Projet-bras-robot-ESME-2021/Rasp-Hand/README.md

## Rasp-Hand project
The project is a Hand controlled by a Ps4 joystick and a keypad.
The hand is able to move in 3 different axes.
And should be able to pick a non fragile item 

In Code you can find the whole code.
In Automat, how to launch the code at boot of raspberry.
In HandProject, the hole interpreter (environment).
In other, the links and some other unnecessary files.
In 3D, the 3D modelisation of the hand in solidworks.

This project is made by Paul Gautier, Ines Aivazian and Warith Hussain.
It was in charge of Antoine.
