Projet-bras-robot-ESME-2021/Rasp-Hand/Code/README.md

this is the code with every piece of code separated
 - PSJoystick to give a function to the button of the joystick
 - Motorconfig for all the method of controlling a motor
 - TheMain to manage everything
