Projet-bras-robot-ESME-2021/Rasp-Hand/Rapport_groupe14.pdf

ESME Sudria Paris

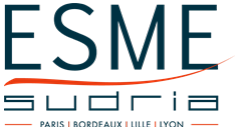
[picture p1: figure]

- 1 -

## REALISATION D’UN BRAS DE ROBOT D’AIDE AUX PERSONNES À MOBILITÉ RÉDUITE

Auteurs : | Encadrants :
AIVAZIAN Inès | FERSZTEROWSKI Antoine
HUSSAIN Warith | CALDAS Alex
GAUTIER Paul

30 mai 2021

- 2 -

# Table des matières

1. Présentation du projet | 5 - 7
1.1 Introduction |
1.2 Liste des exigences |
1.3 Schéma global |
2. Informatique | 8 - 22
2.1 Configuration moteur |
2.2 Mappage de la manette de PS4 |
2.3 Configuration et mappage du keypad |
2.4 Organisation du code main |
2.5 Automatisation |
3. Électronique | 23 - 26
3.1 Composants utilisés |
3.2 Schéma électronique |
4. Mécanique | 27 - 34
4.1 Calculs théoriques |
4.2 Procédé |
4.2.1 Base |
4.2.2 Tronc |
4.2.3 Articulation 1 |
4.2.4 Articulation 2 |
4.2.5 Pince |
5. Management | 35 - 36
5.1 Diagramme de Gantt |
5.2 Difficultés et Résultats |
6. Bilan | 37
6.1 Conclusion |
6.2 Ouverture |

Sources

- 3 -

# Liste des figures

1 Schéma global du projet |
2 Schéma global du projet (partie informatique) |
3 Code configuration moteur (1) |
4 Code configuration moteur (2) |
5 Code mappage de la manette de PS4 (1) |
6 Code mappage de la manette de PS4 (2) |
7 Code mappage de la manette de PS4 (3) |
8 Code mappage de la manette de PS4 (4) |
9 Code mappage de la manette de PS4 (5) |
10 Code mappage de la manette de PS4 (6) |
11 Code configuration et mappage du keypad (1) |
12 Code configuration et mappage du keypad (2) |
13 Code configuration et mappage du keypad (3) |
14 Code configuration et mappage du keypad (4) |
15 Code configuration et mappage du keypad (5) |
16 Code configuration et mappage du keypad (6) |
17 Code configuration et mappage du keypad (7) |
18 Code configuration et mappage du keypad (8) |
19 Code configuration et mappage du keypad (9) |
20 Code configuration et mappage du keypad (10) |
21 Code main |
22 Automatisation (1) |
23 Automatisation (2) |
24 Schéma global du projet (partie électronique) |
25 Raspberry pi 3B+ |
26 Servomoteurs MG996R |
27 Convertisseur DC-DC LM2596 |
28 Clavier 4x4 (keypad) |
29 Manette de PS4 |
30 Schéma électronique |
31 Schéma global du projet (partie mécanique) |
32 La D-H représentation du bras de robot |
33 Modélisation 3D du bras de robot (Solidworks) |
34 Première pièce : la base |
35 Seconde pièce : le tronc (vue du dessous) |
36 Seconde pièce : le tronc (vue du dessus) |
37 Troisième pièce : l’articulation 1 |
38 Quatrième pièce : l’articulation 2 |
39 Cinquième pièce : la pince |
40 Diagramme de Gantt |

- 4 -

# Remerciements

Tout d’abord, il nous semble évident de remercier Monsieur CALDAS et Monsieur FERSZTEROWSKI pour le temps et l’énergie qu’ils ont consacrés à nous encadrer et à nous guider tout au long de ce projet. Nous les remercions également pour avoir mis à notre disposition le matériel de l’école, afin de réaliser au mieux notre projet. Malgré la situation actuelle, Monsieur FERSZTEROWSKI a su se rendre disponible au maximum via teams pour nous aider.

Nous tenons ensuite à remercier Madame THERY et les élèves de la Maker Team de nous avoir donné l’accès au FabLab, notamment pour l’impression 3D de nos pièces.

Nous remercions aussi quelques élèves de l’ESME Sudria qui ont pu nous apporter une aide ponctuelle sur la partie théorique du module mécanique.

Pour finir, nous remercions tous nos professeurs de nous avoir enseigné le savoir essentiel qui nous a permis de mener à bien ce travail.

- 5 -

# 1. Présentation du projet

## 1.1 Introduction

Que ce soit à la suite d’une expérience fortuite ou de longues études sur un sujet, l’Homme essaie toujours d’améliorer sa qualité de vie. En commençant par la maitrise du feu, il est aujourd’hui dans l’ère du numérique. Pour effectuer une tâche plus rapidement ou avec plus de précision par exemple, bon nombre de processus sont automatisés, à l’instar des chaines de production automobiles, grâce à la robotique.

Un robot permet d’effectuer, grâce à un système de commande automatique à base de micro-processeur, une tâche précise pour laquelle il a été conçu dans le domaine industriel, scientifique, militaire ou domestique. Dans le cadre de notre projet, nous souhaitons nous focaliser sur l’aspect médical et essayer de venir en aide aux personnes à mobilité réduites. En effet, en France, plus de 8 millions de personnes déclarent avoir une ou plusieurs déficiences motrices, ce qui représente environ 13% de la population.

Nous avons donc décidé de consacrer notre réflexion à la création d’un bras robotisé pour venir en aide aux personnes qui subissent une motricité difficile, et parfois impossible.

Le premier bras articulé (Unimate) est créé en 1954 par l’américain George Devo dans le but d’être utilisé dans l’industrie nucléaire.
Depuis, les bras robotisés se sont propagés à tous les domaines et permettent de faire de nombreuses tâches : déplacer de lourds objets, aider les chirurgiens lors d’opérations complexes, récupérer des échantillons sur des astéroïdes…

Notre objectif est donc de répondre à la problématique suivante : Comment pourrions-nous aider les personnes à mobilité réduite, grâce à nos connaissances et aux acquis de la technologie ?

Dans ce cahier des charges, nous aborderons plusieurs parties. Dans un premier temps, nous présenterons le projet dans sa globalité. Ensuite, nous expliquerons en détail les trois grands modules qu’il comporte : l’informatique, l’électronique et la mécanique. Pour finir, nous étudierons l’aspect management d’un tel processus.

- 6 -

## 1.2 Liste des exigences

Le but de ce projet est de réaliser un bras robotisé pouvant bouger sur trois axes, muni d’une pince et pouvant attraper des objets du quotidien plus ou moins lourds. Pour ce faire, plusieurs exigences nous ont été données :

Déplacement

- Le système doit avoir 3 degrés de liberté
- Le système doit être contrôlable grâce à une manette
- Le système doit déplacer un objet d’un point A à un point B
- Le système doit effectuer des mouvements avec fluidité

Équipements

- Le système doit être muni d’une pince
- Cette pince doit permettre la saisie d’un objet non fragile

Technique

- L’ensemble des pièces mécaniques seront à imprimer à l’imprimante 3D
- Les pièces seront modélisées sur Solidworks
- Le système sera contrôlé par raspberry

Livrable

- Le code et la documentation seront livrés sous forme de répertoire GitHub
- L’ensemble du livrable permettra à toute personne extérieure au projet de le reproduire

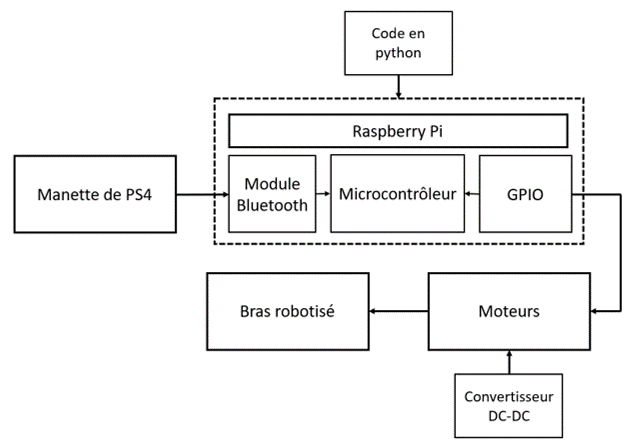
[picture p2: figure]

- 7 -

## 1.3 Schéma global

Figure 1 : Schéma global du projet

Tout d’abord, nous avons utilisé une manette de PS4 qui envoie les données utilisées par Bluetooth à la carte Raspberry Pi. Celle-ci s’occupe de traiter ces données grâce à un code implémenté en python. Ensuite, les moteurs deviennent pilotables en activant les joysticks et bouton de la manette. Enfin, nous avons utilisé un convertisseur DC-DC qui permet d’alimenter les servomoteurs.

Avant de débuter le projet, nous nous sommes préparés à rencontrer des difficultés, que ça soit au niveau du code comme au niveau de la modélisation et de l’impression 3D. Cependant, nos attentes vis-à-vis de ce projet reposent sur des conditions exigées et nous nous sommes efforcés de mener au mieux possible ce travail d’équipe.

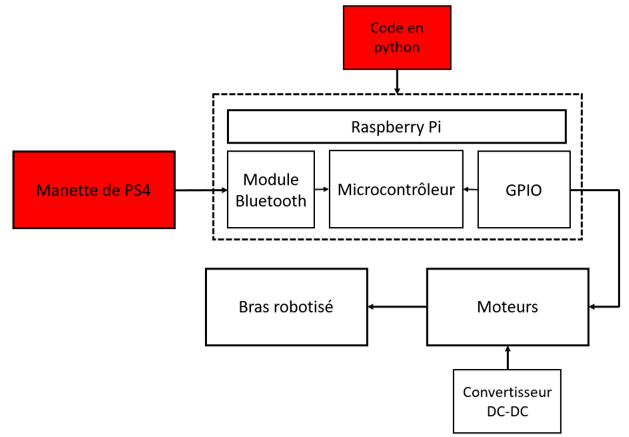
[picture p3: figure]

- 8 -

# 2. Présentation du projet

Figure 2 : Schéma global du projet (partie informatique)

Le code final du projet est séparé en 4 blocs distincts : la configuration du moteur, le mappage de la manette de PS4, la configuration et le mappage du keypad, et enfin le code main faisant appel aux fonction nécessaires.

C’est donc dans cet ordre bien défini que la partie informatique sera détaillée avec des captures d’écran pour chaque sous-partie.

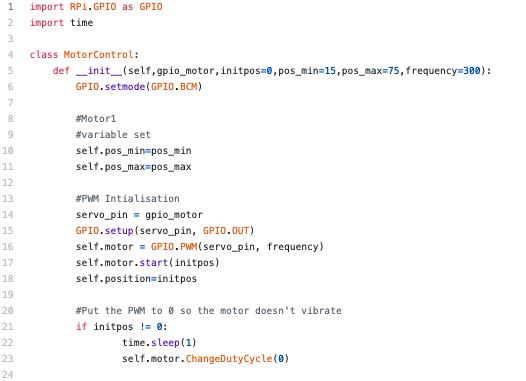
[picture p4: figure]

- 9 -

## 2.1 Configuration moteur

Les servomoteurs sont contrôlés en position à l’aide d’une PWM qui est expliquée plus en détails dans la partie Électronique. La carte Raspberry Pi ayant 2 pins PWM hardware, nous utilisons des GPIOs basiques pour générer une SoftPWM. Nos moteurs sont des servos digitaux et il est donc possible d’augmenter la fréquence afin d’améliorer la précision des positions. Dans ce cas, nous avons utilisé une fréquence de 300 Hz.

Figure 3 : Code configuration moteur (1)

La commande Import RPI.GPIO permet d’importer une librairie qui est nécessaire afin d’utiliser les GPIOs de la Raspberry Pi.
Pour ce projet, nous avons utilisé 4 moteurs avec une configuration presque similaire, et donc coder des classes et des méthodes afin de les configurer et les contrôler. Les objets de chaque moteur seront créés dans le module principal à l’aide des paramètres situés dans le constructeur.
Les moteurs ont chacun un pin assigné (sinon ils vont tourner en même temps), on met donc en paramètre le pin du moteur, ici gpio_motor.

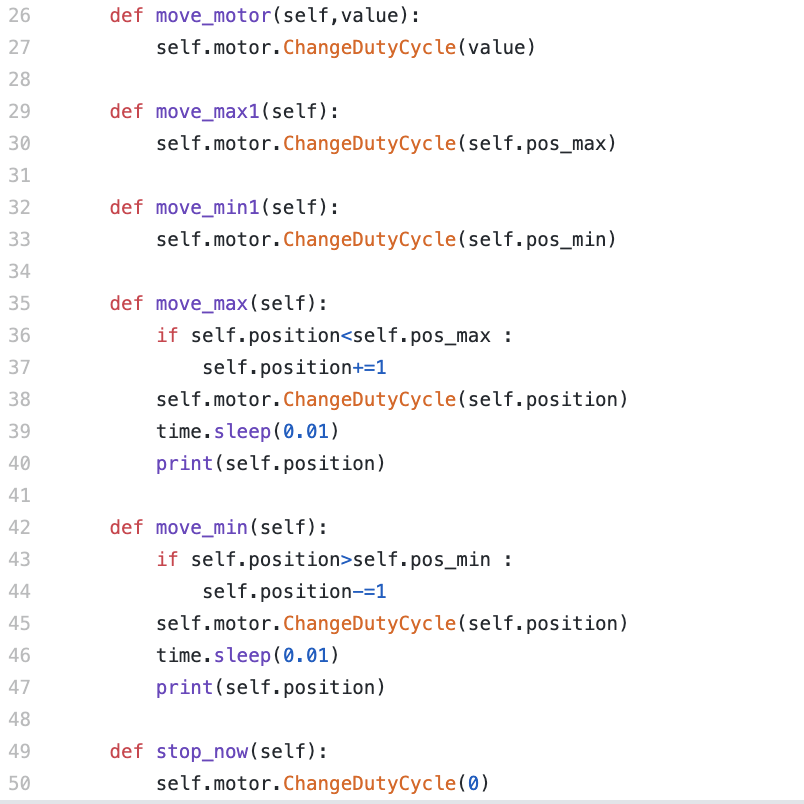
[picture p5: figure]

- 10 -

Puis, nous avons initialisé 3 autres paramètres qui ont une valeur par défaut.
- La position initiale, qui est à 0 par défaut qui signifie que le moteur ne tournera pas et ne prendras pas de position en particulier.
- La position minimale, qui est à 15 par défaut qui correspond à 0°.
- La position maximale, qui est à 75 qui correspond à 180°
Lorsque l’on donne une position initiale au moteur (initpos différent de 0), on laisse le temps au moteur de prendre la position, et on remet la PWM à 0, à l’aide de la fonction ChangeDutyCycle, pour stopper les tremblements du moteur.

Figure 4 : Code configuration moteur (2)

- 11 -

Nous avons créé des méthodes et des classes afin de contrôler le moteur ; pour cela, il y a 3 façons de procéder :
- Move_motor qui prend en paramètre une valeur (entre la position min et la position max) afin d’atteindre une position voulue. Cette méthode est pratique lorsque nous voulons atteindre une position précise.
- Move_min1 et Move_max1 qui permettent d’atteindre la position minimale et la position maximale. Mais associer à la fonction stop_now, qui elle remet la PWM à 0, nous pouvons arrêter le moteur avant qu’elle n’atteigne la position.
Cette méthode fonctionne seulement pour les servos Moteur MG996R en high torque. La raison de se fonctionnement et la différence des moteurs testé sera expliquée dans la partie électronique.
- Move_min et Move_max sont des fonctions qui font incrémenter et décrémenter la variable de position et la renvoie au moteur pour changer la position et la maintenir. Sachant qu’en maintenant une PWM à une valeur particulière le moteur peux avoir des interférences et tremblé. On peut donc mettre la PWM à 0 avec stop_now, pour stopper le moteur.

En stoppant le moteur, le moteur devient hors tension, et perd donc de sa puissance. Avec le poids du bras, le moteur tourne et fais rabaisser les bras. Il ne faut donc pas mettre la PWM à 0 afin de maintenir le bras en position voulu.

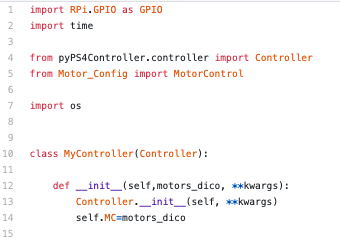
[picture p6: figure]

- 12 -

## 2.2 Mappage de la manette de PS4

La manette de PS4 se connecte à la Raspberry Pi via le module Bluetooth interne à la carte, et nous récupérons les données de la manette grâce à la librairie pyPS4Controller.
Dans la librairie, la class Controller est celle qui initialise la connexion. Quand une manette est connectée, elle à un fichier dans ce chemin ‘/dev/input/js0’ il faut donc appeler la class Controller avec en paramètre « interface = » le chemin. Avec la méthode « listen », on attend que la manette se connecte. Elle vérifie si le fichier existe dans le chemin donné pendant un temps timeout qui vaut 30s par défaut.
Puis on écoute quelle touche est appuyée, qui va faire lancer les méthodes de la Classe Action dépendant des touches appuyées.
Jusque-là nous avons expliqué comment fonctionne la librairie ; dans notre code, on importe la librairie et on surcharge la class Action afin de pouvoir donner de nouvelles actions à nos touches ce qui va nous permettre de contrôler les moteurs.

Figure 5 : Code mappage de la manette de PS4 (1)

Nous importons donc la librairie mais aussi notre class de Configuration Moteur, afin d’utiliser les méthodes pour les contrôler.
Dans notre Module principal qui fait exécuter tout notre programme, nous avons créé un dictionnaire qui va regrouper les 4 moteurs. Nous mettons donc un dictionnaire en paramètre “motors_dico“ et le mettons dans une variable de classe Self.MC.

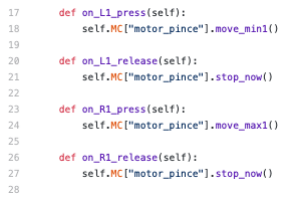
[picture p7: figure]
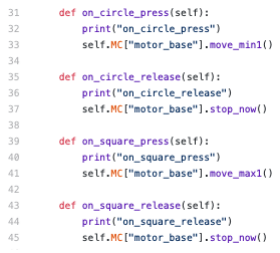
[picture p8: figure]

- 13 -

Figure 6 : Code mappage de la manette de PS4 (2)

Nous utilisons les boutons R1 et L1 de la manette de PS4 pour serrer ou desserrer la pince. Comme vous pouvez le voir, on appelle le dictionnaire stocker dans Self.MC, on annonce lequel des moteurs on souhaite contrôler, dans ce cas “motor_pince“, puis pour la pince. Puisque nous avons mis les servomoteurs en rotation continue, ils sont contrôlables uniquement par le sens et la vitesse. Nous utilisons donc la méthode move_max1 et move_min1 pour choisir le sens de rotation et nous stoppons le moteur lorsque l’on relâche le bouton.

Figure 7 : Code mappage de la manette de PS4 (3)

Vu que nous avons choisi de mettre les moteurs à rotation continue sur la base et la pince, pour le moteur de la base nous utilisons le même principe que pour la pince. Ici, nous avons utilisé les boutons rond et carré pour faire tourner le bras par rapport à la base.

Le code pour les articulations 1 et 2 sont toujours en phase de test.

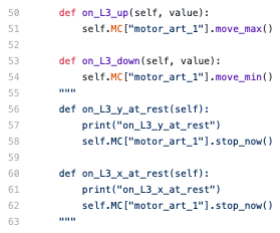
[picture p9: figure]
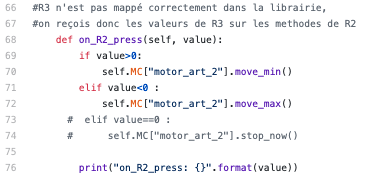
[picture p10: figure]

- 14 -

Le souci est que lorsqu’un moteur n’est plus fourni en PWM (PWM=0) il n’est plus sous tension, or un moteur hors tension ne possède plus ses capacités de couples. Et à ce moment-là, il ne maintient plus le bras dans sa position. C'est pourquoi nous utilisons les méthodes move_max et move_min pour ces moteurs afin de les contrôler en position et de maintenir la position avec la PWM constamment allumée.

Figure 8 : Code mappage de la manette de PS4 (4)

Comme vous pouvez le voir ici, nous avons commenté la partie où nous mettons la PWM à 0 car sinon le bras retombe.
Nous utilisons l’axe Y du joystick gauche de la manette pour contrôler la première articulation. À savoir que les joysticks renvoient des valeurs tant qu’ils changent de position. Les méthodes de déplacement du moteur ne font qu’incrémenter et décrémenter seulement lorsque nous changeons la position. La position étant très précise, tant qu’on ne met pas le joystick tout en haut ou tout en bas, la position ne reste pas stable donc la méthode se relance constamment et fait donc incrémenter et décrémenter en continue tant qu’on ne relâche pas le joystick.

Figure 9 : Code mappage de la manette de PS4 (5)

- 15 -

Les gâchettes R2 et L2 renvoient aussi des valeurs en fonction de la pression sur la touche. Mais le mappage n’ayant pas été bien fait dans la librairie, on_R2_press correspond en fait à R3_up et R3_down. Lorsque l’on baisse le joystick droit la méthode on_R2_press retourne une valeur négative et lorsque l’on monte le joystick, une valeur positive est retournée. Et lorsqu'on relâche le joystick, value vaut 0. On vérifie donc la valeur retournée et on fonction de son signe on incrémente ou décrémente sa position. Et lorsque value vaut 0, on ne fait rien pour maintenir la position donnée.

Figure 10 : Code mappage de la manette de PS4 (6)

Lorsque nous appuyons sur le bouton option, on lance le script disconnect.sh qui fais déconnecter la manette de la Raspberry Pi. Ceci permet de redonner la main au Keypad.

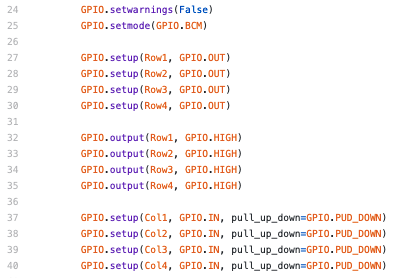
[picture p11: figure]

- 16 -

## 2.3 La configuration et mappage du Keypad

Pour le Keypad, il existe des librairies sur internet mais voulant un parfait contrôle sur ce que l’on fait avec le keypad, et n’ayant pas pu trouver ça sur les librairies existantes, nous avons réutilisé un code que l’un de nous a eu l’occasion de coder lors de son semestre à Lisbonne, mais en langage C. Nous avons donc traduit le code en python mais par manque de temps, nous n'avons pas pu l’optimiser.

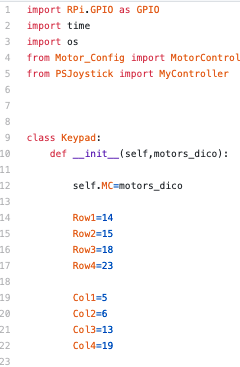
[picture p12: figure]

Figures 11 et 12 : Code configuration et mappage du keypad (1 et 2)

Notre Keypad est notre contrôleur principal, il peut contrôler le moteur mais aussi passer la main à la manette. C'est pourquoi on importe la Class MyController et MotorControl.

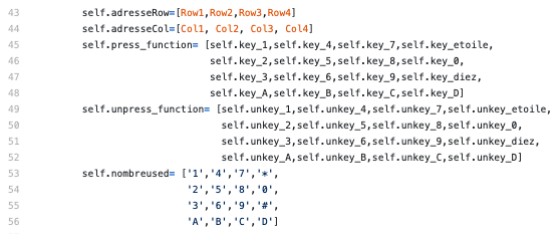
[picture p13: figure]

- 17 -

Comme pour la manette à l’appelle du keypad nous lui rentrons en paramètre le dictionnaire des moteurs pour pouvoir contrôler les moteurs un par un. On le stock donc dans une variable de class self.MC. On associe les pins utilisés sur la Raspberry au variable Row et Col correspondant. Puis on initialise les pins des lignes en pin de sortie et on les met directement en état haut. On initialise ensuite les pins des colonnes en pins d’entrées et on les associe digitalement à des résistance pull-down, la Raspberry nous permet d’utiliser des résistances pull-up et pull-down en software. Les résistances pull-down permettent de maintenir les pins d’entrées en état bas lorsqu’aucune valeur n’est rentrée. Cela évite d’avoir des valeurs flottantes lorsqu’aucune touche n’est appuyée.

Figure 13 : Code configuration et mappage du keypad (3)

Nous créons ici différents tableaux. La première pour regrouper les adresses des lignes et la deuxième pour regrouper les adresses des colonnes.
Puis nous faisons 3 tableaux qui correspondent à nos matrices d’entrée. Les variables à l’intérieur vont être sélectionnées en fonction du bouton appuyé.

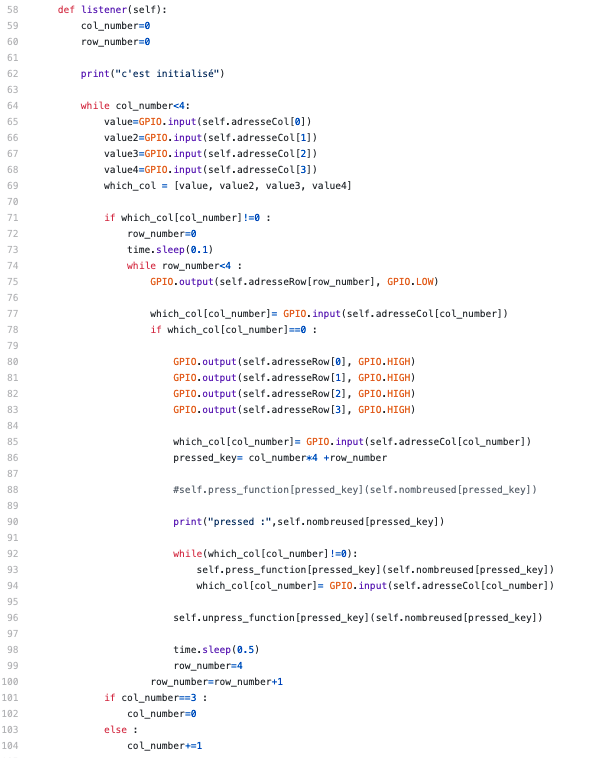
[picture p14: figure]

- 18 -

Figure 14 : Code configuration et mappage du keypad (4)

Le principe du keypad est expliqué dans la partie électronique. On a une variable col_number qui s’incrémente de 0 à 4 et qui tourne en boucle infinie car si cette variable vaut 4 elle est remise à 0. Cela sert à regarder la valeur de chaque colonne et que si une des colonnes (qui lit un état bas par défaut) lit un état haut, on essaye de savoir quelle ligne nous correspond.
On stocke donc la valeur que reçoivent les colonnes dans un tableau (l.80 à l.85), et si l’une des valeurs est différentes de 0, on sait que c’est un bouton de cette colonne qui est appuyé.

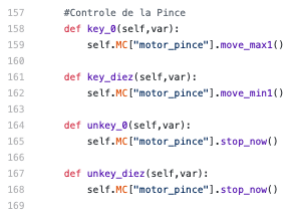
[picture p15: figure]
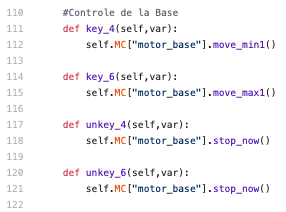
[picture p16: figure]

- 19 -

Maintenant pour vérifier la ligne du bouton appuyé, on fait incrémenter la variable row_number de 0 à 4. Pour chaque valeur de row_number on met à l’état bas la ligne correspondante et on vérifie si la colonne lit un changement d’état. Si la colonne lit un état bas, on a trouvé la colonne et la ligne correspondant au bouton que nous avons appuyé.
Dès que c’est trouver, on remet les pins des lignes en état haut ; à ce moment-là, la colonne lit un état haut et c’est seulement lorsque l’on relâche le bouton que le pin de la colonne lira un état bas (celui de la résistance pull-down).
Grâce à cette méthode nous pouvons lancer des fonctions que nous voulons lancer qu’une seule fois si le bouton est appuyé, relancer des fonctions tant que le bouton est appuyé, et lancer des fonctions lorsque c’est relâché. On peut donc utiliser la méthode d’incrémentation de la position des moteurs qui nécessite d’être appelé tant que le bouton est appuyé, et utiliser la méthode d’arrêt des moteurs lorsque l’on relâche le bouton.
On a un time.sleep d’une demie seconde à chaque appui de bouton pour laisser le temps aux états de se recalibrer.
La variable pressed_key nous fait le calcul pour avoir la position du bouton correspondant à la ligne et la colonne dans les matrices de fonctions.

Figures 15 et 16 : Code configuration et mappage du keypad (5 et 6)

Key_4 est la méthode qui permet de mettre la position du moteur de la base à 0° et key_6 à 180°, en relâchant les boutons, les méthodes unkey_4 et unkey_6 se déclenchent et stoppent le moteur. On utilise donc le même principe pour la pince.
On utilise les boutons 4 et 6 pour faire tourner la base. Et les boutons 0 et # pour contrôler la pince.

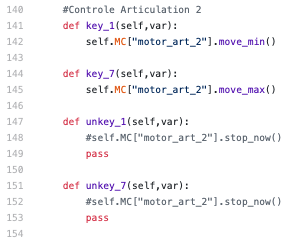
[picture p17: figure]
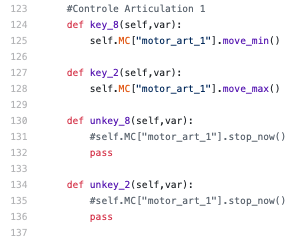
[picture p18: figure]
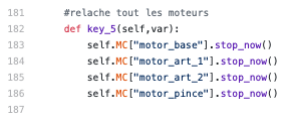
[picture p19: figure]

- 20 -

Figures 17 et 18 : Code configuration et mappage du keypad (7 et 8)

Les moteurs des articulations ont à peu près le même principe que les 2 autres moteurs mais en relâchant les boutons on ne doit juste rien faire, on ne met pas la PWM à 0.
Et ici comme pour la manette de PS4, on utilise les méthodes move_min et move_max pour les moteurs pour modifier les valeurs de position et la maintenir. On utilise ici les touches 2 et 8 pour l’articulation 1 et les touches 1 et 7 pour l’articulation 2.

Figure 19 : Code configuration et mappage du keypad (9)

Vu que le maintien d’une position via la PWM fait trembler les moteurs, en appuyant sur 5 on met toute les PWM à 0 même si cela relâche les moteurs. On a le même principe qu'un bouton de Kill program. Mais nous pouvons reprendre nos mouvements après.

Figure 20 : Code configuration et mappage du keypad (10)

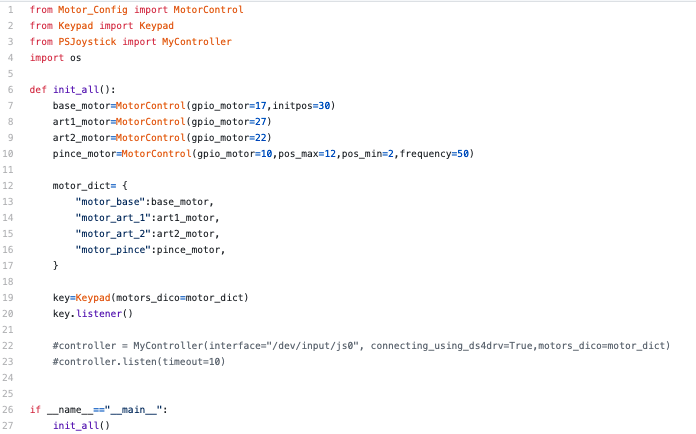
[picture p20: figure]

- 21 -

La touche * nous permet de nous connecter à la manette de PS4, on essaye de lancer le script connect.sh, pour connecter la manette via Bluetooth et on lance la méthode listen de la manette pour l’utiliser, si la connexion ne s’est pas faite au bout de 10s, on repasse sur le keypad.

On ne peut pas utiliser les 2 contrôleurs simultanément (le Keypad et la manette de PS4). Donc quand on se connecte sur la manette de PS4, il faut la déconnecter pour repasser sur le keypad.

## 2.4 Organisation Main

Figure 21 : Code main

Ici on lance tout notre programme. On crée un objet de moteur pour chaque moteur en associant le pin pour chacun, leur position initiale s’ils en ont, la position minimale et maximale et la fréquence si ça doit changer.
On met tous ces objets dans le dictionnaire motor_dict, et on leur donne des noms que l’on réutilise dans nos Class Keypad et Controller (la manette de PS4).
Puis on lance le listener du keypad en mettant en paramètre de la classe le dictionnaire.

- 22 -

## 2.5 Automatisation

On utilise des scripts Bash pour automatiser notre projet, car nous voulons qu’il fonctionne sans utiliser l’interface graphique de la Raspberry Pi.

Figure 22 : Automatisation (1)

Ce script est nommé runarm.sh, il permet d’activer notre environnement puis lancer le fichier Python ProjectMain.py qui est notre Main.
On lance ce script à l’allumage de la Raspberry Pi en rajoutant “sudo bash /home/pi/runarm.sh &” dans le rc.local qui est un script qui se lance quand on allume la Raspberry Pi.

Figure 23 : Automatisation (2)

Voici le script connect.sh qui permet de connecter un appareil en Bluetooth avec une adresse MAC donnée. Ici, celle de la manette de la PS4.

On a le même script pour déconnecter la manette.

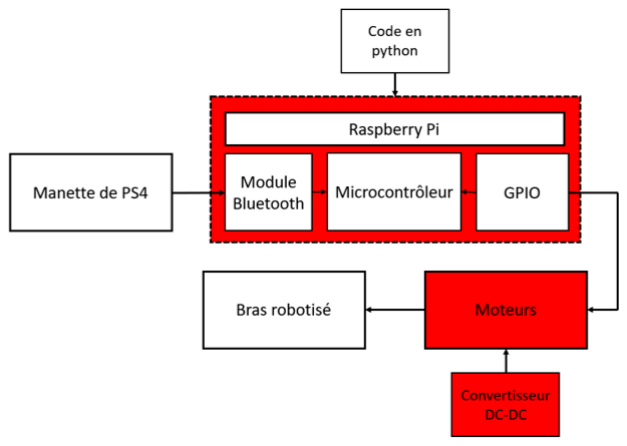
[picture p21: figure]
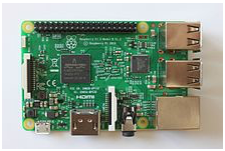
[picture p22: figure]

- 23 -

# 3. Électronique

Figure 24 : Schéma global du projet (partie électronique)

## 3.1 Composants utilisés

- Raspberry Pi 3B +

Figure25 : Raspberry Pi 3B+

Le Raspberry Pi est un nano-ordinateur monocarte à processeur ARM de la taille d'une carte de crédit conçu par des professeurs du département informatique de l'université de Cambridge dans le cadre de la fondation Raspberry Pi3.

Le 14 mars 2018, la fondation Raspberry Pi annonce la mise à jour du Raspberry Pi 3 vers le modèle B+. On y trouve une mise à jour du processeur Broadcom BCM2837B0 64 bit à quatre cœurs ARM Cortex-A53 cadencé à 1,4 GHz au lieu du 1,2 GHz. La puce Cypress CYW43438 est remplacée par une nouvelle puce CYW43455 supportant le WiFi Dual-band 802.11ac et la version 4.2 du Bluetooth. Et d'une prise en charge du Power over Ethernet grâce à un élément supplémentaire.

- 24 -
- Servomoteurs MG996R

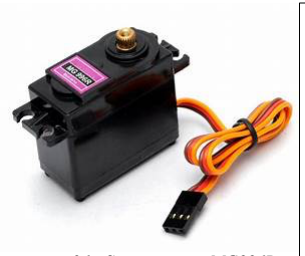
[picture p23: figure]

Figure 26 : Servomoteurs MG996R

- Convertisseur DC-DC LM2596

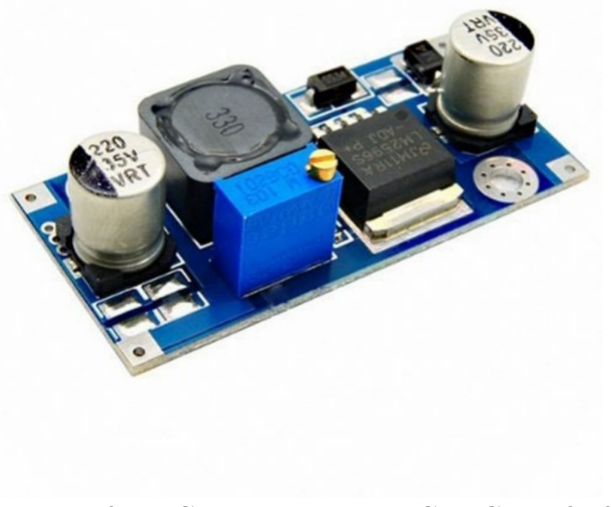
[picture p24: figure]

Figure 27 : Convertisseur DC-DC LM2596

Le MG996R est un servomoteur numérique robuste à engrenages métalliques. Il dispose d’un couple de 11kg/cm et est très utilisé dans les domaines de la robotique, modélisme, domotique et prototypage.
Comme les autres servomoteurs RC, le moteur tourne de 0° à 180° en fonction du cycle d’utilisation de la PWM fournie à sa broche de signal.
Un signal de 0.5ms correspond à 0° et un signal de 2.5ms à 180°. Le temps correspondant à une fréquence de 50Hz est 20 ms. On divise donc 0.5 par 20 pour avoir le dutyCycle correspondant
(notre pos_min et pos_max de l’initialisation du moteur).

Câble rouge : + 5V
Câble orange : PWM
Câble marron : GND

Un convertisseur DC-DC permet de délivrer une tension différente de celle qu’il reçoit.
Pour notre projet, nous utilisons un convertisseur DC-DC LM2596 pouvant recevoir entre 3,2V et 40V et transmettre en sortie de 1,25V à 35V.
Celui-ci est essentiellement composé de deux condensateurs (un en entrée et l’autre en sortie), un transistor, des diodes, une bobine et un potentiomètre. On peut observer la tension de sortie grâce à un voltmètre et ainsi régler la tension souhaitée. Pour modifier cette tension, il suffit de tourner la vis sur le potentiomètre.
Ici, nous désirons une tension de 5V pour alimenter nos moteurs.

- 25 -
- Clavier 4x4 (keypad)

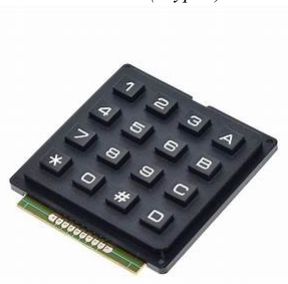
[picture p25: figure]

Figure 28 : Clavier 4x4 (keypad)

- Manette de PS4

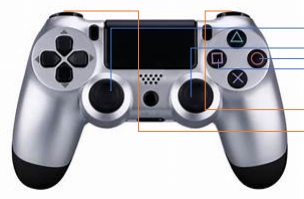
[picture p26: figure]

Figure 29 : Manette de PS4

Le clavier possède 4 broches pour les colonnes et 4 broches pour les lignes qui se relient au moment où l’on appuie sur un bouton. On met donc les colonnes en entrées avec une résistance pull down qui permet de lire un état bas quand rien d’autre n’est entré cela évite de recevoir une valeur flottante et ainsi fausser nos résultats et les lignes en sorties.
Les lignes envoient une valeur différente de 1 (l’état haut) et au moment où l’on appuie sur une touche, la colonne correspondante lit une valeur et après il faut donc déterminer la lignes du bouton appuyé. Pour cela, sachant que la colonne lit un état haut car un bouton est appuyé, on va mettre à l’état bas une par une les lignes afin que la colonne lise un état bas de nouveau. Dès qu’on connait la ligne et la colonne correspondant à la touche appuyée, on sait quelle touche est appuyé.

Instructions pour les servomoteurs

Analogue gauche : Avancer l’articulation 1 Analogue droit : Reculer l’articulation 1 Carrée : Tourner à gauche la base
Rond : Tourner à droite la base
R1 : Serrer la pince
L1 : Desserrer la pince
Option : Passer de la manette au keypad

## 3.2 Schéma électronique

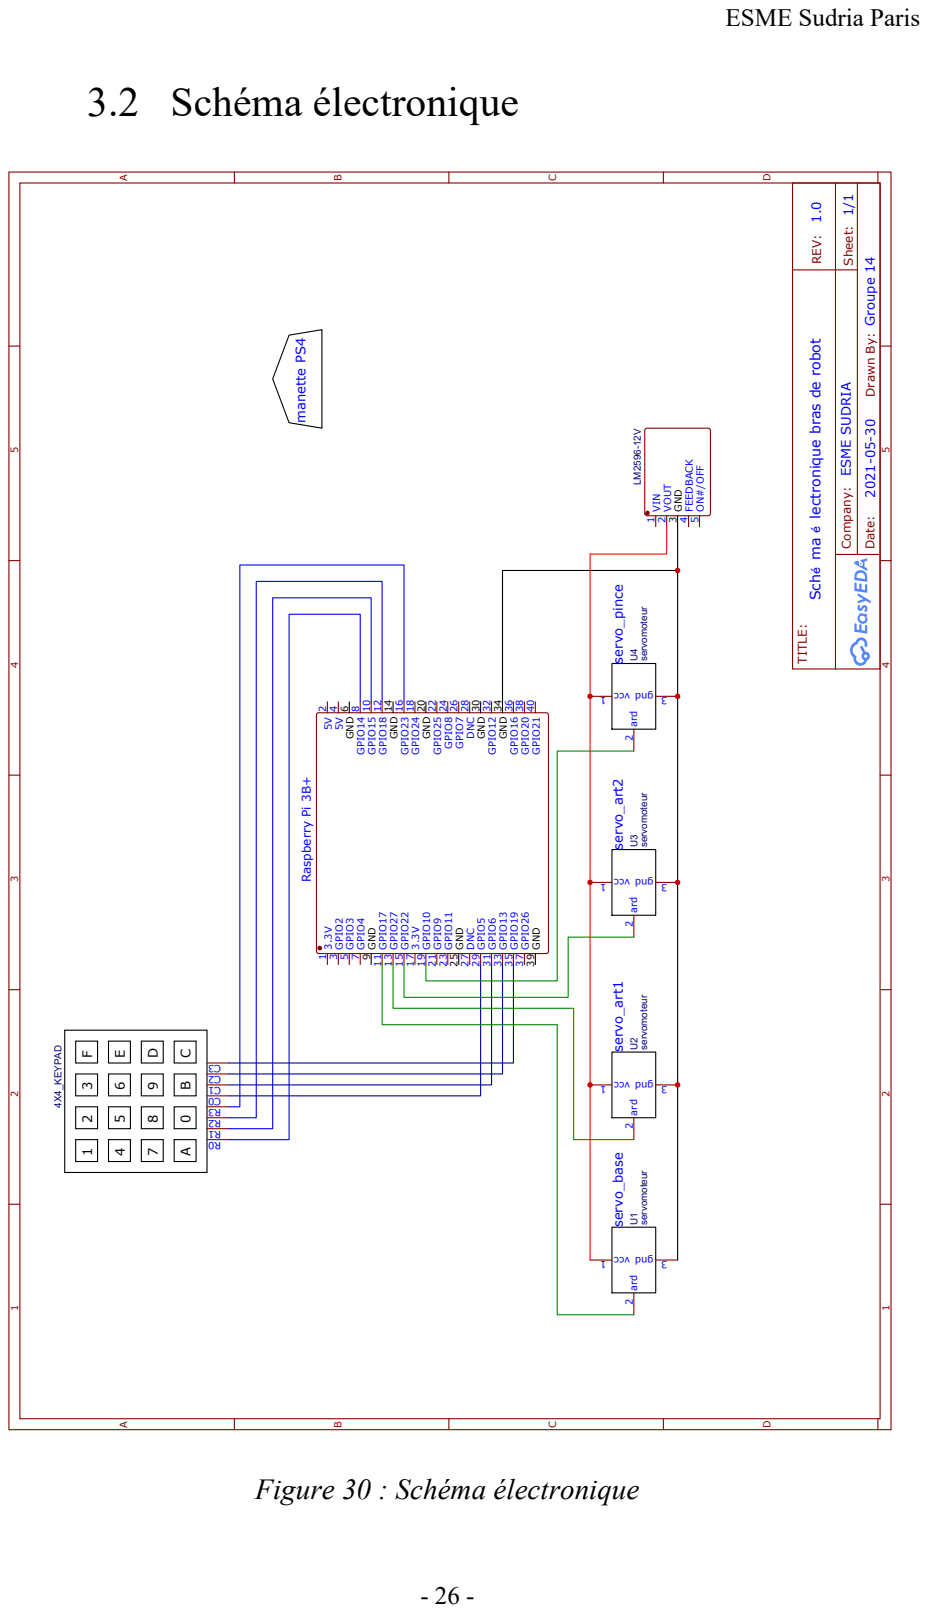
[picture p27: page 26]
TITLE:; Date: 2021-05-30; Sheet: 1/1; servomoteur; servo_base; servo_art1; servo_art2; servo_pince; VIN 1; VOUT 2 GND 3; FEEDBACK 4 ON#/OFF 5; 4X4_KEYPAD; manette PS4; GPIO2 3; GPIO3 5; GPIO4 7 GND 9; GPIO17 11; GPIO27 13; GPIO22 15 3.3V 17; GPIO10 19 GPIO9 21; GPIO11 23 GND 25 DNC 27; GPIO5 29; GPIO6 31; GPIO13 33; GPIO19 35; GPIO26 37; Raspberry Pi 3B+

Sché ma é lectronique bras de robot REV: 1.0

Drawn By: Groupe 14

Company: ESME SUDRIA

GND 39 GPIO21 40 GPIO20 38 GPIO16 36 GND 34 GPIO12 32 GND 30 DNC 28 GPIO7 26 GPIO8 24 GPIO25 22 GND 20 GPIO24 18 GPIO23 16 GND 14 GPIO18 12 GPIO15 10 GPIO14 8 GND 6 5V 4 5V 2

Figure 30 : Schéma électronique

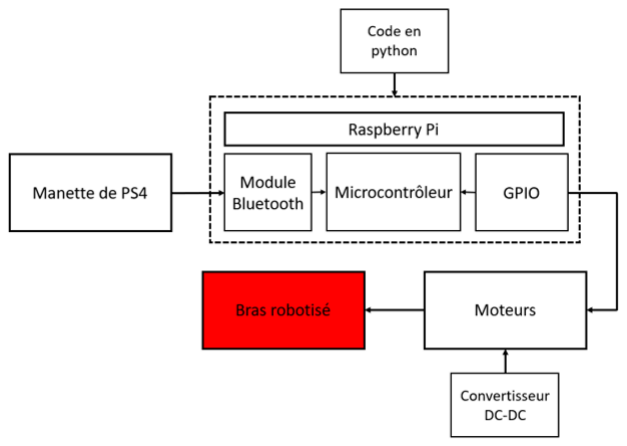
[picture p28: figure]

- 27 -

# 4. Mécanique

Figure 31 : Schéma global du projet (partie mécanique)

## 4.1 Calculs théoriques

Dans ce rapport, nous avons souhaité effectuer les calculs vus en cours de Systèmes Articulés. Il nous semblait important de faire cette partie théorique, afin de mieux intégrer la pratique.

Représentation du bras robotisé
Notre bras robotisé évolue dans l’espace selon trois axes, comme annoncé plus haut : x, y et z. Nos articulations sont toutes rotoïdes, pivotant selon les axes z0, z1 et z2, avec des angles respectifs theta1, theta2 et theta3.
Nous avons également associé d1 à la hauteur du tronc, a2 à la longueur du bras 1, et a3 à la longueur du bras 2 plus celle de la pince.

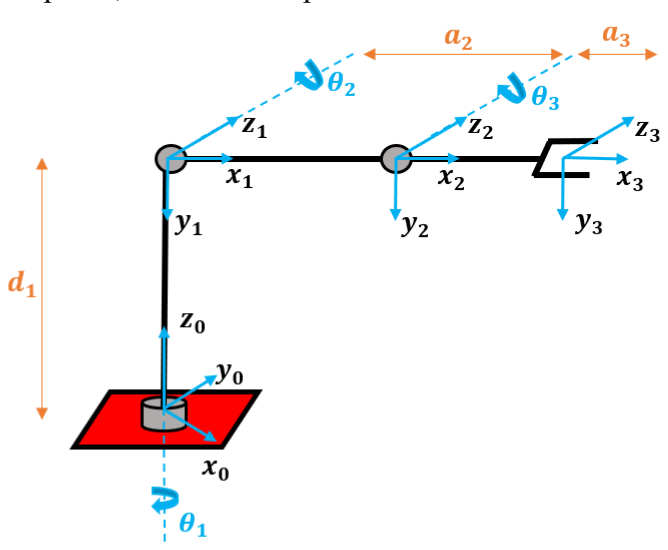
[picture p29: figure]

- 28 -

Pour cette première partie, nous avons représenté notre robot R-R-R suivant :

Figure 32 : La D-H représentation du bras de robot

Paramètres de Denavit-Hartenberg
Nous remplissons le tableau ci-dessous pour chaque paramètre, ce qui va nous aider pour la suite des calculs.
Axe | θ | d | a | α
1 | θ1 | d1 | 0 | -π/2
2 | θ2 | 0 | a2 | 0
3 | θ3 | 0 | a3 | 0

- 29 -

Modèle géométrique direct
Le modèle géométrique direct permet de calculer les coordonnées opérationnelles du robot avec sa position et ses coordonnées articulaires.
Ensuite, nous calculons le modèle géométrique direct. Pour cela, nous devons trouver :

T "#$%

&'()* = T +
, = T +

-. T -

.. T .

,

T +

, = %

C- | 0 −S- | 0
S- | 0 | C- | 0
0 −1 | 0 | d-
0 | 0 | 0 | 1

,.%

C. | −S. | 0 a.C.
S. | C. | 0 a.S.
0 | 0 | 1 | 0
0 | 0 | 0 | 1

, . %

C, | −S, | 0 a,C,
S, | C, | 0 a,S,
0 | 0 | 1 | 0
0 | 0 | 0 | 1

,

⟹ T "#$%

&'()* = T +

, = %

C-C., | −C-S., | S- | C-(a,C., + a.C.)
S-C., | −S-S., | C- | S-(a,C., + a.C.)
−S./, | −C./, | 0 −a,S., − a.S. + d-
0 | 0 | 0 | 1

,

Modèle géométrique inverse
Le modèle géométrique inverse permet de déterminer la configuration des liaisons, en fonction de la position et de l’orientation de l'effecteur du robot. Nous souhaitons ensuite trouver le modèle géométrique inverse. Nous devons trouver w(q) :

w(q) =

⎣

⎢

⎢

⎢

⎢

⎢

⎢

⎡ C-(a,C., + a.C.)
S-(a,C., + a.C.)
−a,S., − a.S. + d-S-exp :

q,
π <

C-exp :

q,
π <
0 | ⎦

⎥

⎥

⎥

⎥

⎥

⎥

⎤

On cherche ensuite à exprimer q!, q", q#.
Pour cela nous utilisons plusieurs formules avec lesquelles on trouve q! et q# assez facilement :
q- = atan2(w. , w,)
q, = π. lnGw0
. , w1

- 30 -

Pour trouver q" , on isole C" et S" afin de l’exprimer en fonction de w! , w" et w# :

C. = w- − C-a, − C.,
C-a.
S. = w, + a,S., − d-a.
q. = atan2(

w, + a,S., − d-a.

,

w- − C-a, − C.,
C-a.

)

Matrice Jacobienne de l’outil
Cette matrice sert à exprimer la vitesse de l’outil en fonction des vitesses articulaires. Elle est utile lorsqu’on souhaite commander un robot pour qu’il suive la trajectoire au préalable calculée.
Pour déterminer v(q), on dérive w(q) par apport à q!, q" et q#. On obtient :

v(q) =

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
−S-(a,C., + a.C.) −C-(a,S., + a.S.) −a,C-S., C-(a,C., + a.C.) −S-(a,S., + a.S.) −a,S-S.,
0 | −a,C., − a.C. | −a,C.,
C-ex p :

q,
π < | 0 | 0

−S-ex p :

q,
π < | 0 | 0
0 | 0 | 0 | ⎦

⎥

⎥

⎥

⎥

⎥

⎥

⎤

Matrice Jacobienne du manipulateur

J(q) =

⎣

⎢

⎢

⎢

⎢

⎡

−S-(a,C., + a.C.) −C-(a,S., + a.S.) −a,C-S., C-(a,C., + a.C.) −S-(a,S., + a.S.) −a,S-S.,
0 | −a,C., − a.C. | −a,C.,
0 | −S- | S-
0 | C- | C-
1 | 0 | 0 | ⎦

⎥

⎥

⎥

⎥

⎤

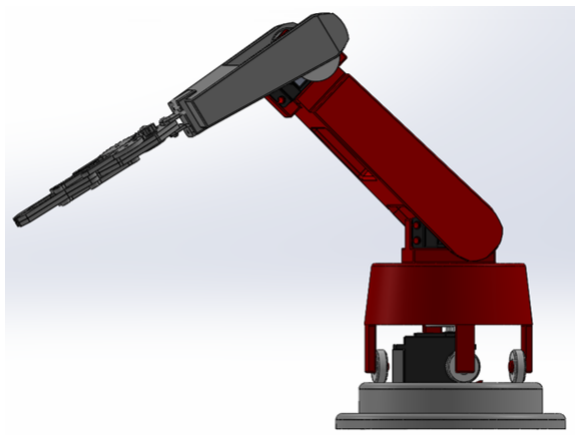
[picture p30: figure]

- 31 -

## 4.2 Procédé

En ce qui concerne la partie mécanique de notre projet, nous avons longuement hésité sur la manière de procéder.

Notre première idée était de construire l’entièreté du robot avec des pièces de mécano dans le but d’obtenir un bras de robot le plus solide possible. Finalement, nous nous sommes rendu compte que cela nous compliquerait la tâche, surtout pour assembler les servomoteurs aux différentes parties du robot. Et puis, nous ne trouvions pas exactement ce que nous avions en tête sur le marché.
Nous avons donc décidé de partir sur une création totale des pièces sur le logiciel de modélisation 3D SolidWorks. Avant de commencer, nous avons établis un schéma sur papier avec les mesures que nous voulions donner à notre robot, sa forme globale et les liaisons que nous allions mettre en place entre chaque partie. Il se compose d’une base, d’un tronc surélevé permettant de faire pivoter le robot, de deux bras, et d’une pince. Afin de ne pas mettre tout le poids du robot sur les moteurs, nous avons pensé à utiliser des roulements à billes. Pour pouvoir avoir une vue d’ensemble pour l’assemblage sur SolidWorks et que cela soit plus simple pour les mesures, nous avons trouvé une modélisation 3D des moteurs MG996R que nous allions utiliser, et nous avons modélisé leurs hélices ainsi que les roulements à billes.

Finalement, nous avons décidé de fixer notre robot sur une planche en bois pour qu’il puisse gagner en stabilité, et si besoin, d’utiliser les pièces de mécano pour le renforcer.

Figure 15 : Modélisation 3D du bras de robot (Solidworks)

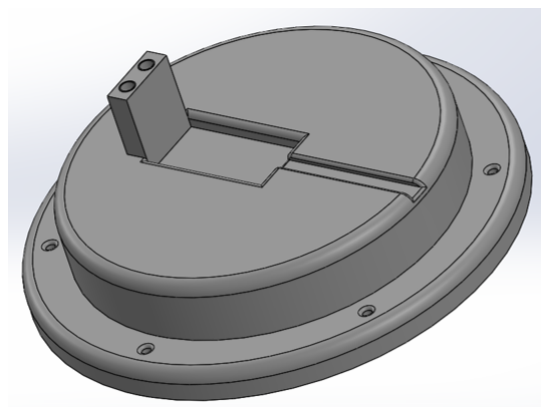
[picture p31: figure]
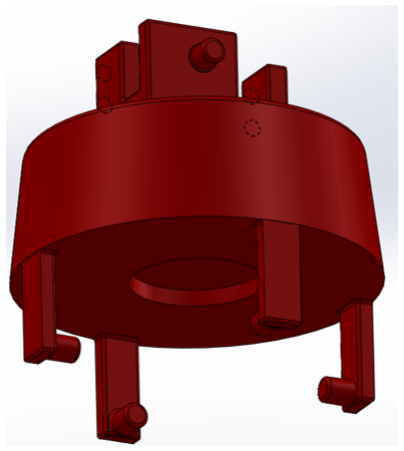
[picture p32: figure]

- 32 -

## 4.2.1 Base

Pour la première pièce qui est la base, nous avons simplement créé un socle de 15cm de diamètre, pouvant contenir un premier moteur dans un creux. Ce premier moteur permet au bras robotisé de pivoter sur lui-même. Nous avons également fait des trous pour pouvoir fixer le moteur à la base et fixer celle-ci sur une planche en bois, ainsi que des rails pouvant accueillir les câbles.

Figure 16 : Première pièce : la base

## 4.2.2 Tronc

La deuxième pièce est ce que nous avons appelé le “tronc”. Il s’agit d’une pièce cylindrique de 12cm, venant se fixer au moteur à l’aide d’un trou creusé sur le dessous, et venant se poser sur la base avec quatre roulements à billes.

Figure 17 : Seconde pièce : le tronc (vue du dessous)

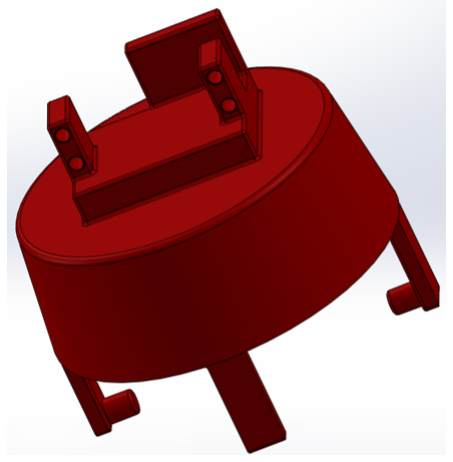
[picture p33: figure]
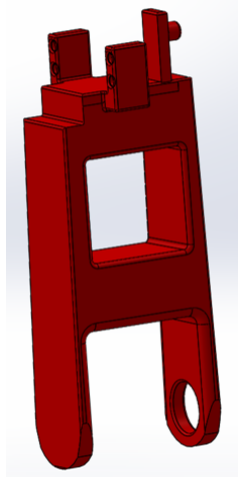
[picture p34: figure]

- 33 -

Sur le dessus de la pièce, nous avons construit un espace qui accueillera le deuxième moteur. Celui-ci va permettre au bras de bouger en hauteur. Nous avons également fait un axe permettant de fixer le premier bras à l’aide d’un roulement à billes.

Figure 18 : Seconde pièce : le tronc (vue du dessus)

## 4.2.3 Articulation 1

La troisième pièce est le premier bras de notre robot. Il mesure 20cm de hauteur et 7cm de largeur. Le troisième moteur sera positionné en haut du bras et il permettra au deuxième bras de bouger en hauteur et d’apporter également la longueur au bras robotisé. Nous avons créé un espace sur une des pattes du bras afin d’y glisser un roulement à billes. Celui-ci fera la liaison avec le tronc.

Figure 19 : Troisième pièce : l’articulation 1

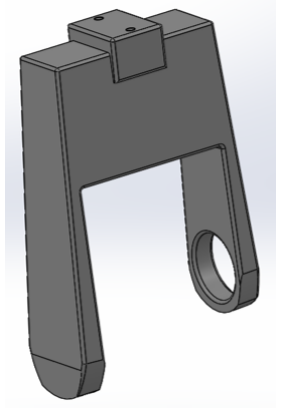
[picture p35: figure]
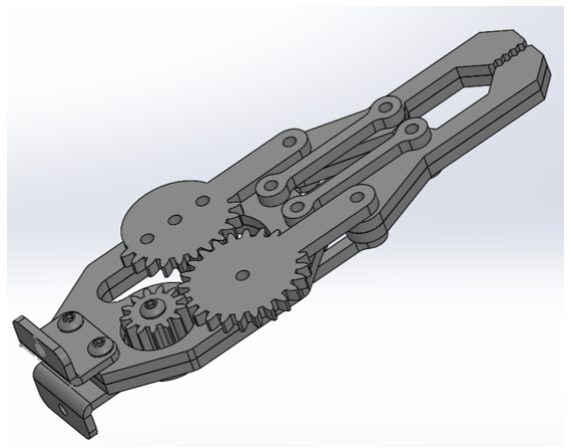
[picture p36: figure]

- 34 -

## 4.2.4 Articulation 2

Ensuite, il y a le deuxième bras qui mesure 11,70 cm. Nous mettrons également un roulement à billes pour pouvoir fixer cette pièce au premier bras.

Figure 20 : Quatrième pièce : l’articulation 2

## 4.2.5 Pince

La cinquième pièce est la pince, pièce finale du robot, qui mesure 13cm de long. Le quatrième moteur va être fixé en dessous de la pince à l’aide d’une vis, et entraîner un engrenage central qui entraînera les deux engrenages secondaires qui, eux-mêmes, feront bouger les bras de la pince. Afin que la pince attrape mieux les objets, nous avons fixé des bouts de caoutchouc sur ses extrémités.

Figure 21 : Cinquième pièce : la pince

- 35 -

# 5. Management

## 5.1 Diagramme de Gantt

Le diagramme de Gantt, couramment utilisé en gestion de projet, est l'un des outils les plus efficaces pour représenter visuellement l'état d'avancement des différentes activités (tâches) qui constituent un projet.

Il permet de répertorier toutes les tâches à accomplir pour mener le projet à bien, et indique la date à laquelle ces tâches doivent être effectuées (le planning).

Le diagramme de Gantt étant trop grand, nous l’avons coupé en deux pour qu’il puisse être plus lisible.

Diagramme de Gantt | 01-mars | 02-mars | 03-mars | 04-mars | 05-mars | 08-mars | 09-mars | 10-mars | 11-mars | 12-mars | 15-mars | 16-mars | 17-mars | 18-mars | 19-mars | 22-mars | 23-mars | 24-mars | 25-mars | 26-mars | 29-mars | 30-mars | 31-mars | 01-avr | 02-avr | 05-avr | 06-avr | 07-avr | 08-avr | 09-avr | 12-avr | 13-avr | 14-avr | 15-avr | 16-avr | 19-avr | 20-avr
Bras de robot | M | T | W | T | F | M | T | W | T | F | M | T | W | T | F | M | T | W | T | F | M | T | W | T | F | M | T | W | T | F | M | T | W | T | F | M | T
Réunions | Réunion 18h

Réunion
18h

Réunion
18h

Activité 1 : Analyse

Analyse des besoins

Rédaction du cahier des
charges

Schéma synoptique

Spécifications des composants

Commande de matériel

Spécifications du code

Activité 2 : Développment

Phase de code

Modélisation 3D

Phase de Test

Activité 3 : Finalisation

Rédaction du rapport

Assemblage

Cahier des charges

Schéma synoptique

Spécifications du code

Recherche des composants

Analyse des besoins

21-avr | 22-avr | 23-avr | 26-avr | 27-avr | 28-avr | 29-avr | 30-avr | 03-mai | 04-mai | 05-mai | 06-mai | 07-mai | 10-mai | 11-mai | 12-mai | 13-mai | 14-mai | 17-mai | 18-mai | 19-mai | 20-mai | 21-mai | 24-mai | 25-mai | 26-mai | 27-mai | 28-mai | 30-mai | 31-mai | 01-juin | 02-juin | 03-juin | 04-juin
W | T | F | M | T | W | T | F | M | T | W | T | F | M | T | W | T | F | M | T | W | T | F | M | T | W | T | F | S | M | T | W | T | F

Réunion
18h

Réunion
18h

Remise du
rapport 18h

Soutenance de
Projet

Assemblage

Acitivté 3 : Finalisation

Rédaction du rapport

Commande de matériel

Activité 1 : Analyse

Modélisation 3D

Phase de code

Activité 2 : Développement

- 36 -

## 5.2 Difficultés et Résultats

Au cours de la réalisation de nos travaux, nous avons rencontré diverses difficultés dans différents domaines.

Modélisation/Impression 3D

- Manque de précision au niveau de la modélisation du bras n°1 et 2, notamment lors de l’emboîtement de ces deux pièces. Il a donc fallu réimprimer ces deux pièces en modifiant certaines mesures sur Solidworks.
- Lors de la mise en place de supports (utiles lors de l’impression), certains d’entre eux étaient inutiles et difficiles à retirer de la pièce.

Composants

- Nous avons eu 4 types de servomoteurs à tester ; l’un d’entre eux étaient défectueux, et les deux autres ne correspondaient pas au cahier des charges qui nous a été donné.

Assemblage des pièces

- Par le manque de temps au niveau des impressions 3D, nous avons dû creuser approximativement le “tronc“ pour y fixer le servomoteur qui le relie à la base.

Mise à part ces quelques difficultés, ce projet a été une réussite.
Tout d’abord, il a été accompli dans la limite du temps imparti et nous a permis d’acquérir de nouvelles compétences notamment au niveau de la modélisation 3D et du code.
De plus, la communication entre les membres de ce groupe et l’encadrant de notre projet était excellente même si cela s’est fait à distance via teams.
Nous sommes heureux de pouvoir présenter un projet fonctionnel qui peut venir en aide aux personnes à mobilité réduite.
Nous partageons l’entièreté du code ainsi que la documentation sur Github afin de permettre à n’importe qui de comprendre et même de réaliser ce projet.

- 37 -

# 6. Bilan

## 6.1 Conclusion

Ce travail nous a permis de concevoir un projet de A à Z : un bras robotisé bougeant sur trois axes et permettant d’attraper un objet pas fragile ni trop lourd, contrôlé par une manette de PS4. Nous sommes parvenus à le réaliser en utilisant nos connaissances en termes d’informatique, d’électronique et de mécanique. Nous en avons aussi beaucoup appris sur ces trois modules, et ce travail nous a permis de gagner en autonomie.

Nous avons également dû nous organiser en groupe : nous nous sommes réunis régulièrement à l’école ou via teams pour se répartir au mieux les tâches et avancer sur le projet petit à petit. Nous avons eu quelques soucis qui ont retardé le planning que nous nous étions imposés, mais nous avons réussi à trouver des solutions, et surtout à ne pas perdre espoir.

## 6.2 Ouverture

A l’avenir, nous pourrions envisager de créer un bras robotisé plus complexe que celui-ci : jouer sur les articulations comme rajouter un bras ou alors donner une fonction de rotation à la pince, créer une interface via laquelle on pourrait directement contrôler le robot, ajouter une caméra, mais également rendre plus « propre » le bras en créant une boîte pour cacher les composants électroniques et améliorer la modélisation 3D de nos pièces…

Il y a beaucoup de choses que l’on pourrait ajouter/améliorer, et cela permettrait une aide encore plus précieuse aux personnes à mobilité réduite qui souhaiteraient bénéficier d’un tel robot !

- 38 -

# Sources

https://www.accessiblepourmoi.com/ce-que-dit-la-loi/les-chiffres-du-handicap/

https://www.monde-proprete.com/sites/default/files/familles_de_deficiences.pdf

https://objectifadvf.wordpress.com/2016/09/02/hemiplegie-paraplegie-tetraplegie/

https://poujouly.net/2012/05/22/convertisseur-dcdc/

https://www.solaris-store.com/content/48-principe-de-fonctionnement-d-un-convertisseur-dc-dc

https://fr.wikipedia.org/wiki/Raspberry_Pi#Modèle_3_B+_(Raspberry_Pi_3+)

https://components101.com/motors/mg996r-servo-motor-datasheet

https://raspberry-pi.fr/servomoteur-raspberry-pi/

Image Raspberry Pi 3B+
https://upload.wikimedia.org/wikipedia/commons/thumb/d/d2/Raspberry_Pi_3_Model_B.JPG/220px-Raspberry_Pi_3_Model_B.JPG

Image Convertisseur DC-DC LM2596 https://tse4.mm.bing.net/th?id=OIP.5nQd_U2SgdZRXKjP8jbKDAHaHa&pid=Api&P=0&w=300&h=300

Image Clavier 4x4 (keypad) https://tse2.mm.bing.net/th?id=OIP.WIb3wZBgXtMjG8csV2ykeAAAAA&pid=Api&P=0&w=300&h=300

Image manette de PS4
https://tse4.mm.bing.net/th?id=OIP.EGTTn8Wsas8JAv8ocU4dvwAAAA&pid=Api&P=0&w=225&h=151
