Projet-bras-robot-ESME-2021/Rasp-Hand/3D/Assemblage_pince_moteur.SLDASM

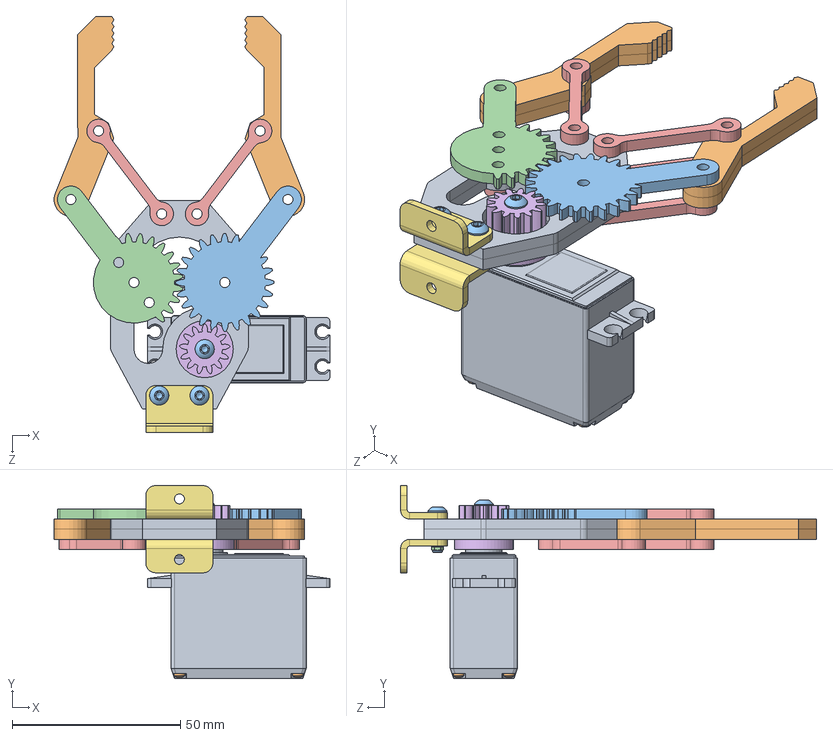
[picture p37: CAD file, 2021-10-26]
3D/Assemblage_pince_moteur.SLDASM
82.0 x 57.4 x 123.7 mm
Arm 03 x 2
Arm 07 x 4
Arm 04
Arm 05
Arm 06 x 6
shaft+engrenage
Arm 02 x 2
Servo Output Shaft
Standard Servo (1501MG)
pan head cross recess screw_iso x 4
socket button head screw_iso x 3
hex thin nut chamfered gradeab_iso x 2
