Projet-bras-robot-ESME-2021/Rasp-Hand/3D/tronc.SLDPRT

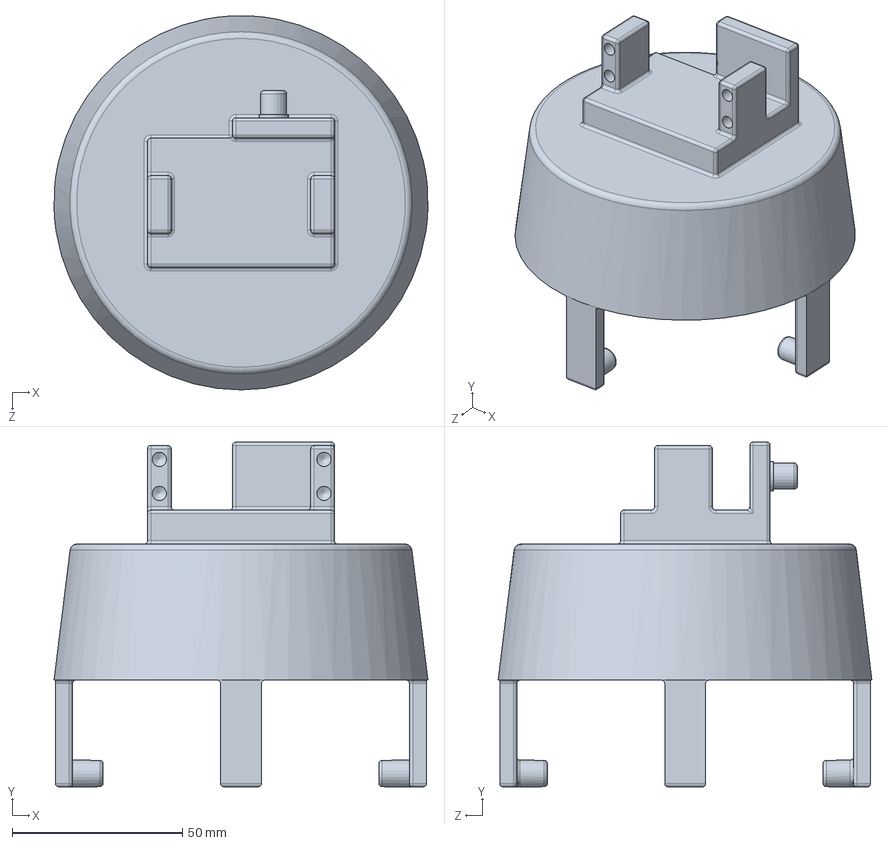
[picture p38: CAD file, 2021-10-26]
3D/tronc.SLDPRT
109.9 x 101.4 x 109.9 mm
