Projet-bras-robot-ESME-2021/Rasp-Hand/3D/Arm 07.SLDPRT

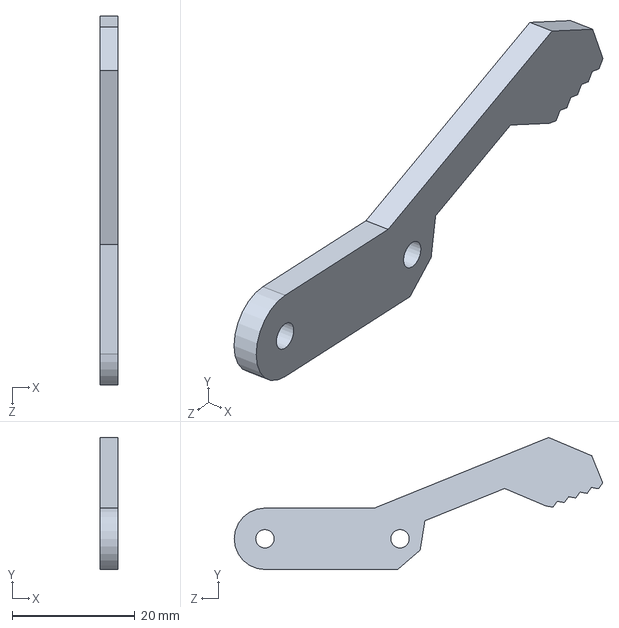
[picture p39: CAD file, 2021-10-26]
3D/Arm 07.SLDPRT
3.00 x 21.5 x 60.0 mm
