Projet-bras-robot-ESME-2021/Rasp-Hand/3D/Arm 04.SLDPRT

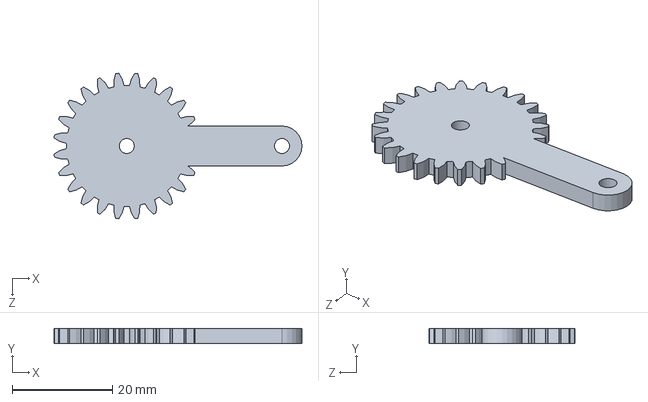
[picture p40: CAD file, 2021-10-26]
3D/Arm 04.SLDPRT
49.5 x 3.00 x 29.1 mm
