Projet-bras-robot-ESME-2021/Rasp-Hand/3D/base - Copie.SLDPRT

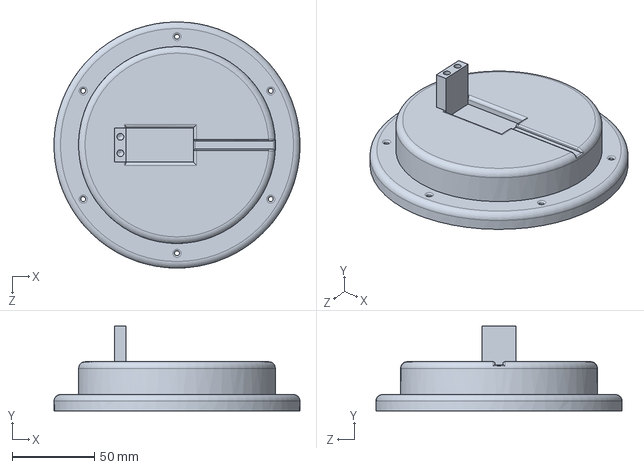
[picture p41: CAD file, 2021-10-26]
3D/base - Copie.SLDPRT
149.9 x 51.7 x 150.0 mm
