Projet-bras-robot-ESME-2021/Rasp-Hand/3D/Arm 02.SLDPRT

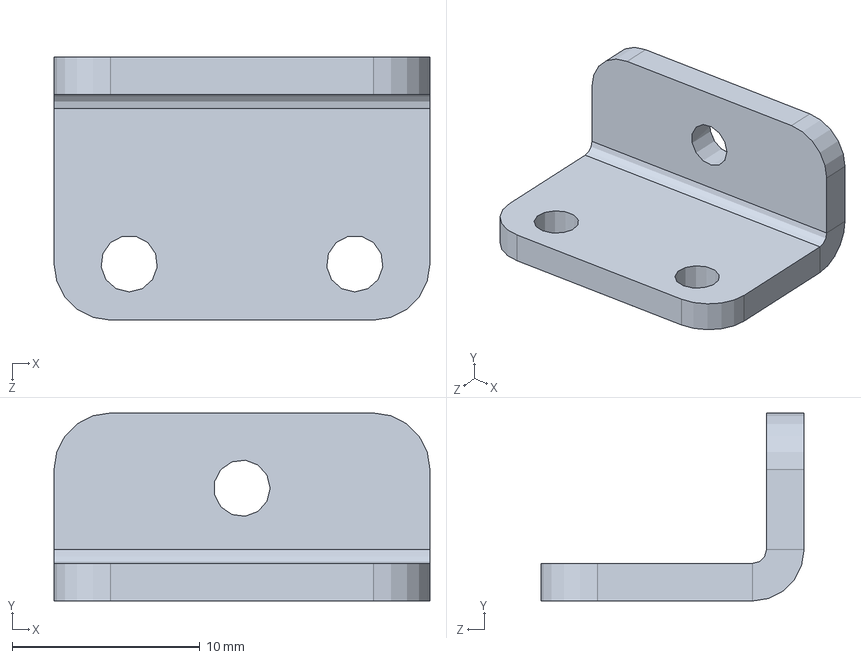
[picture p42: CAD file, 2021-10-26]
3D/Arm 02.SLDPRT
20.0 x 10.0 x 14.0 mm
