Projet-bras-robot-ESME-2021/Rasp-Hand/3D/bras 2 vf - Copie.SLDPRT

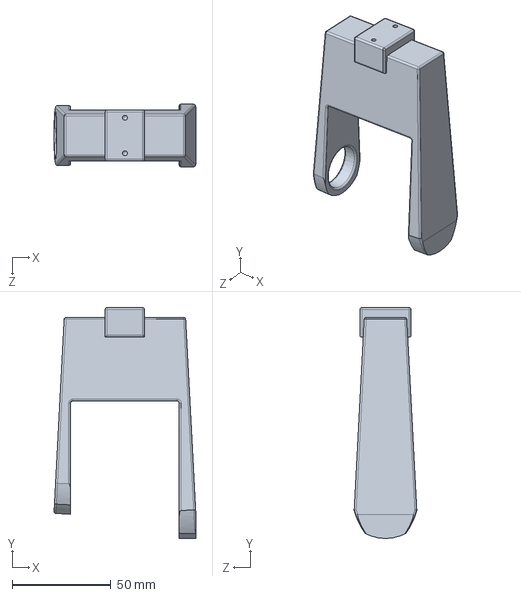
[picture p43: CAD file, 2021-10-26]
3D/bras 2 vf - Copie.SLDPRT
71.9 x 117.1 x 31.8 mm
