Projet-bras-robot-ESME-2021/Rasp-Hand/3D/shaft+engrenage.SLDPRT

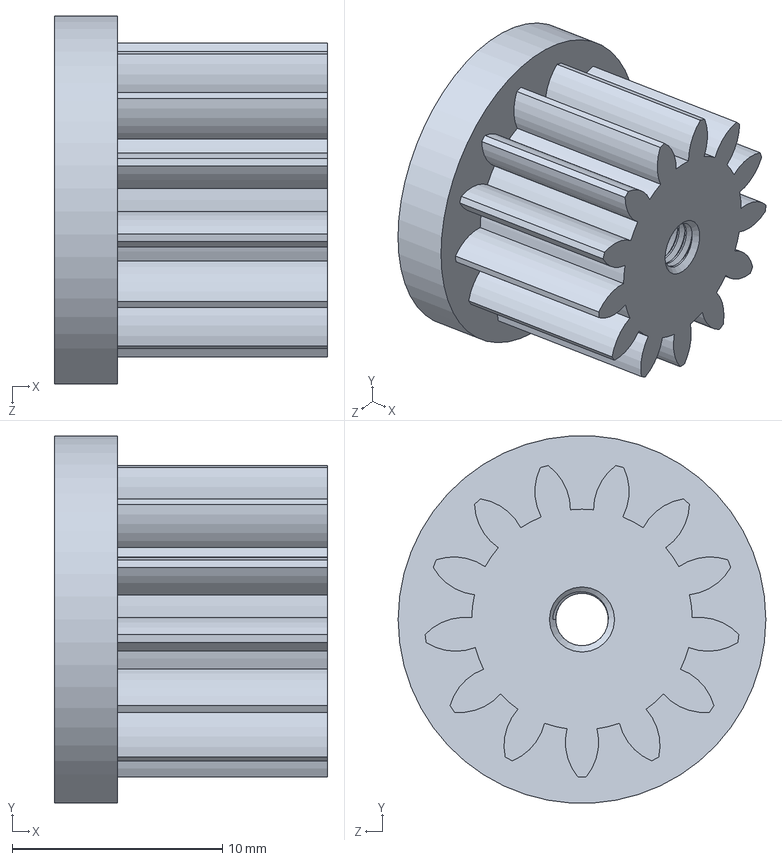
[picture p44: CAD file, 2021-10-26]
3D/shaft+engrenage.SLDPRT
13.0 x 17.5 x 17.5 mm
