Projet-bras-robot-ESME-2021/Rasp-Hand/3D/bras 1.SLDPRT

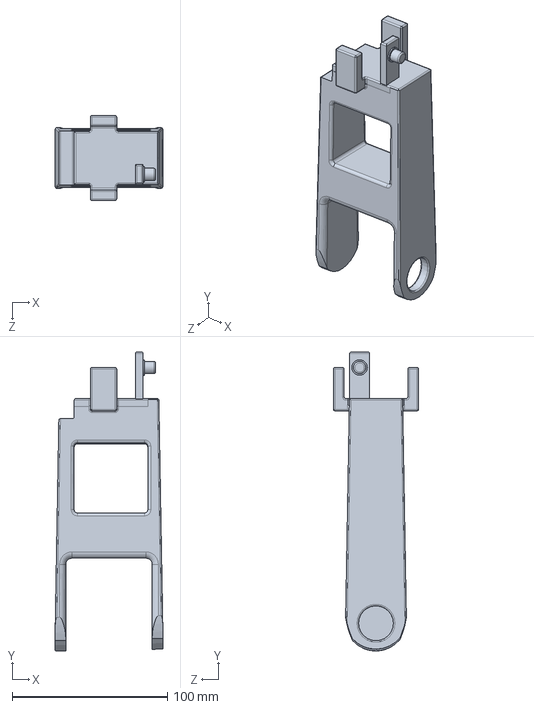
[picture p45: CAD file, 2021-10-26]
3D/bras 1.SLDPRT
70.0 x 192.9 x 55.0 mm
