Projet-bras-robot-ESME-2021/Rasp-Hand/3D/Arm 05.SLDPRT

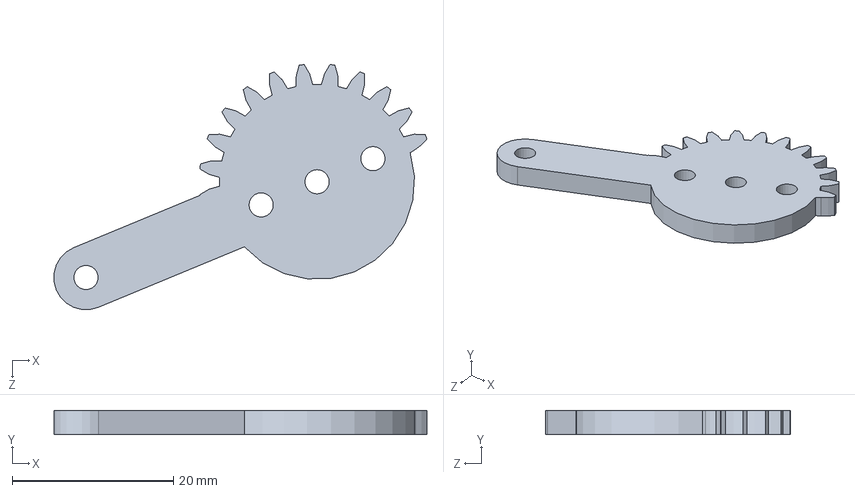
[picture p46: CAD file, 2021-10-26]
3D/Arm 05.SLDPRT
46.2 x 3.00 x 30.4 mm
