Projet-bras-robot-ESME-2021/Rasp-Hand/3D/Arm 03.SLDPRT

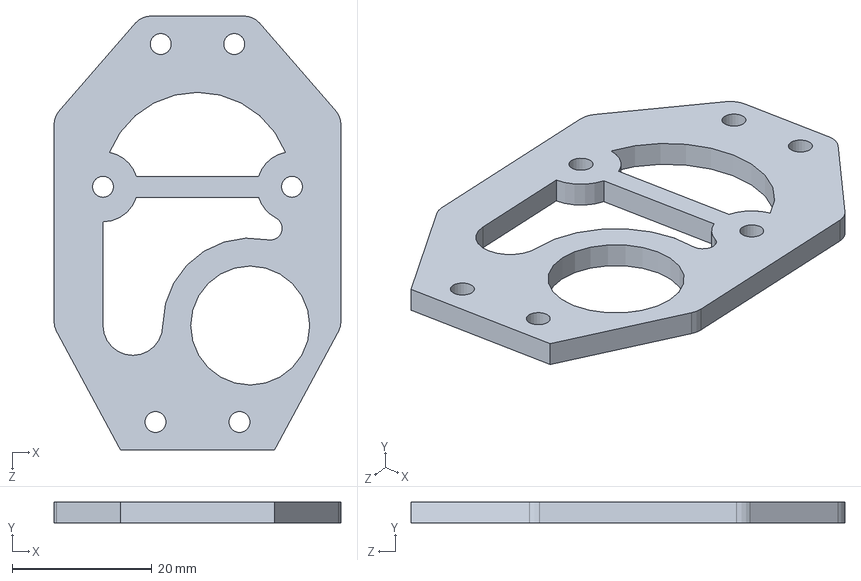
[picture p47: CAD file, 2021-10-26]
3D/Arm 03.SLDPRT
41.0 x 3.00 x 62.0 mm
