Projet-bras-robot-ESME-2021/Rasp-Hand/3D/Arm 06.SLDPRT

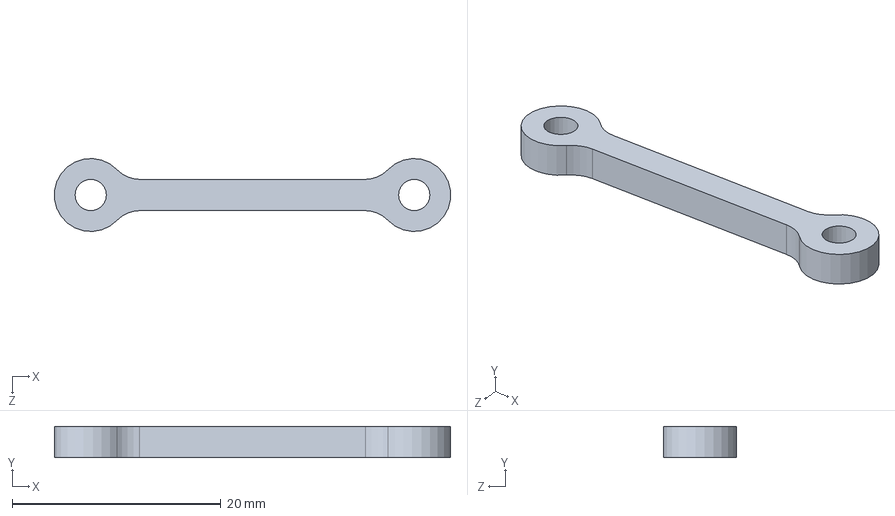
[picture p48: CAD file, 2021-10-26]
3D/Arm 06.SLDPRT
37.9 x 3.00 x 6.99 mm
