Projet-bras-robot-ESME-2021/Rasp-Hand/(commit log)

2021-03-18 le message de Warith
2021-04-02 Create Lien pour Raspberry
2021-04-02 Update Lien pour Raspberry
2021-04-26 Rename Lien pour Raspberry to Other/Lien pour Raspberry
